losteph/EmbeddedControl/Core/Src/main.c

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
/* Includes ------------------------------------------------------------------*/
#include "main.h"

/* USER CODE BEGIN Includes */
#include <stdio.h>
#include "vl53l1x.h"
#include "pid.h"
#include "potentiometer.h"
/* USER CODE END Includes */

ADC_HandleTypeDef hadc1;
DMA_HandleTypeDef hdma_adc1;

I2C_HandleTypeDef hi2c1;

TIM_HandleTypeDef htim2;
TIM_HandleTypeDef htim6;

/* USER CODE BEGIN PV */
/* --- FLAG DI SINCRONIZZAZIONE (volatile perché modificate/lette tra ISR e main) --- */

// Limiti fisici del tubo per la pallina levitante (in mm)
const float SETPOINT_MIN_MM = 40.0f;   // Posizione minima desiderata (fondo tubo)
const float SETPOINT_MAX_MM = 450.0f;  // Posizione massima desiderata (cima tubo)
volatile float setpoint_mm = 50.0f;    // Setpoint effettivo usato dal PID

volatile uint8_t loop_flag = 0;   // Alzata a 1 ogni 26ms dall'interrupt di TIM6
uint8_t print_flag = 0;           // Alzata a 1 ogni 10 cicli (200ms) per la telemetria
uint16_t print_counter = 0;       // Contatore secondario per rallentare le stampe

volatile uint16_t sensor_id = 0; //deve diventare 0xEACC (debug)
volatile uint8_t  sensor_ok = 0; // deve diventare 1 (debug)
volatile uint16_t distance_mm = 0; // i millimetri letti in tempo reale

PID_Controller fan_pid;

volatile float duty_output = 0.0f;
volatile uint32_t ccr_applied = 0;

/* USER CODE END PV */

void SystemClock_Config(void);
static void MX_GPIO_Init(void);
static void MX_DMA_Init(void);
static void MX_TIM6_Init(void);
static void MX_TIM2_Init(void);
static void MX_I2C1_Init(void);
static void MX_ADC1_Init(void);
/* USER CODE BEGIN PFP */
void Read_Sensors(void);
void Compute_PID(void);
void Update_Actuators(void);
void Print_Telemetry(void);
/* USER CODE END PFP */

/* USER CODE BEGIN 0 */
// Reindirizzamento di printf per funzionare sia su SWV/ITM sia su UART
int __io_putchar(int ch) {
    ITM_SendChar(ch);
    return ch;
}


/* USER CODE END 0 */

/**
  * @brief  The application entry point.
  * @retval int
  */
int main(void)
{

  /* MCU Configuration--------------------------------------------------------*/

  /* Reset of all peripherals, Initializes the Flash interface and the Systick. */
	HAL_Init();

  /* Configure the system clock */
  SystemClock_Config();

  /* Initialize all configured peripherals */
  MX_GPIO_Init();
  MX_DMA_Init();
  MX_TIM6_Init();
  MX_TIM2_Init();
  MX_I2C1_Init();
  MX_ADC1_Init();
  /* USER CODE BEGIN 2 */
  /* --- INIZIALIZZAZIONE E AVVIO SERVIZI (Prima del while) --- */
    // Avvia l'acquisizione continua del potenziometro in DMA
  	   Potentiometer_Init(&hadc1);

    // 1. Imposta un duty cycle di test (es. 50% con ARR = 419999 -> CCR = 210000)
      __HAL_TIM_SET_COMPARE(&htim2, TIM_CHANNEL_1, 0);

      // 2. Avvia la generazione PWM hardware sul canale 1 (PA5)
      HAL_TIM_PWM_Start(&htim2, TIM_CHANNEL_1);


      sensor_id = VL53L1X_CheckID(&hi2c1);
      if (sensor_id == 0xEACC) {
          sensor_ok = VL53L1X_Init(&hi2c1);
      }


      // Inizializzazione del PID
      // Ts = 0.0266f (37.5 Hz con ARR=265, PSC=8399)
      // out_min = 0.000f (0% soglia di spunto ventola)
      // out_max = 1.000f (100% tetto massimo per non sparare la sfera fuori dal tubo)
      // Guadagni iniziali indicativi da rifinire al banco: Kp=0.0016f, Ki=0.0002f, Kd=0.00055f
      PID_Init(&fan_pid, 0.0016f, 0.0002f, 0.00055f, 0.0266f, 0.000f, 1.000f);

      HAL_TIM_Base_Start_IT(&htim6);

  /* USER CODE END 2 */

  /* Infinite loop */
  /* USER CODE BEGIN WHILE */
  while (1)
  {




	  /* Controllo ad anello chiuso  */
	  if (loop_flag == 1)
	      {
	          loop_flag = 0; // Reset immediato della flag

	          Read_Sensors();
	          Compute_PID();

	      }
    /* USER CODE END WHILE */

    /* USER CODE BEGIN 3 */
  }
  /* USER CODE END 3 */
}

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
/* USER CODE BEGIN 4 */

void Read_Sensors(void)
{
	// Aggiornamento del setpoint tramite modulo dedicato
	setpoint_mm = Potentiometer_GetSetpoint(SETPOINT_MIN_MM, SETPOINT_MAX_MM);
	printf("Setpoint: %.1f cm \n", (setpoint_mm + 15)/10);


	if (sensor_ok && VL53L1X_DataReady(&hi2c1)) {
		          distance_mm = VL53L1X_GetDistanceMM(&hi2c1);
		      }
  //  printf("VL53L1X ID: 0x%04X, Distanza: %d mm\r\n", sensor_id, distance_mm);

}



void Compute_PID(void)
{
			// Calcolo dell'azione di controllo PID
	        duty_output = PID_Update(&fan_pid, (float)setpoint_mm, (float)distance_mm);

	        // Attuazione sul PWM (TIM2 ARR = 419999 -> base 420000 passi)
	        ccr_applied = (uint32_t)(duty_output * 420000.0f);
	        __HAL_TIM_SET_COMPARE(&htim2, TIM_CHANNEL_1, ccr_applied);
	      //  printf("Duty: %.3f | CCR: %lu\n", duty_output, ccr_applied);

}

/**
  * @brief  Callback del Timer a 37 Hz (scatta esattamente ogni 26 ms).
  *
  */
void HAL_TIM_PeriodElapsedCallback(TIM_HandleTypeDef *htim)
{
    if (htim->Instance == TIM6)
    {
        loop_flag = 1;
    }
}


/* USER CODE END 4 */
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
