losteph/EmbeddedControl/(commit log)

2026-10-20 Delete Core/Inc/vl53l1x_user.h
    senza abilitare i2c per queste prove iniziali nuovi componenti falliva il build. Lo ricreo dopo di nuovo quando abilitiamo la comunicazione
2026-10-20 prova led
2026-10-20 prova PWM con TIM2
2026-10-20 prova2 PWM
2026-10-22 sensore aggiunto, nuova prova
2026-10-22 nuova prova sensore
2026-10-22 Create com.st.stm32cube.ide.mcu.sfrview.prefs
    CC
2026-10-22 Update main.c
    TIMER+CLOCK
2026-10-24 prima prova PID
2026-10-24 pid calibrato
    pid calibrato
2026-10-24 Remove levitating ball system details from README
    Removed sections about the levitating ball system, demonstration video, hardware used, and main pin mapping.
2026-10-26 Aggiunti moduli potenziometer.h/.c con logica per acquisizione setpoint, abilitazione PA0, ADC1 con DMA
2026-10-26 aggiornati valori Timer, PWM, setpoint
2026-10-26 Modify user input and add I2C pin mappings
    Updated user input method to use a linear potentiometer for dynamic setpoint management. Added I2C communication pins for the ToF sensor.
